Gabriel-Amici/telhado_ecologico/README.md

# telhado_ecologico

Estudo do impacto do uso de Telhado Ecológico na temperatura em centros urbanos.

O estudo consistiu em analisar os impactos através de uma comparação em condições controladas: foi montado um protótipo de telhado comum, consistindo em uma placa de MDF coberta com lona impermeável e comparada a um protótipo de telhado verde, consistindo em um *box* de MDF com algumas camadas para fixação vegetal.

O experimento foi realizado em instalações do Departamento de Hidrobiologia da Universidade Federal de São Carlos DHB-UFSCar, como parte de um projeto para a disciplina de **Ciências do Ambiente para Engenharia Física**, sob tutela do Prof. Dr. Hugo Sarmento. 

Os estudantes responsáveis pelo planejamento, construção e análise dos resultados deste projeto são:
- Gabriel A. Amici;
- Giovanni S. Brizotti;
- João V. Moraes;
- Lucas H. F. Senhorini;
- Lucas M. Ribeiro.

Este repositório contém:
- O código fonte utilizado no módulo *arduino* responsável pela coleta de dados e controle de umidade;
- Os dados gravados pelo sistema;
- As ferramentas de análise desenvolvidas;
- Um esboço de artigo detalhando o desenvolvimento e resultados do projeto.
