Gabriel-Amici/telhado_ecologico/(commit log)

2026-01-27 proposta de artigo para publicação em revista de ensino
2026-05-23 Initial commit: Add code and data files to repo
    [DADOS.csv, Dados-05-11.csv, dados-2-5.csv]
